napatGNK/Solar-MPPT-Boost-Charge-Controller/README.md

# Solar MPPT Boost Charge Controller

เครื่องควบคุมการชาร์จแบตเตอรี่จากแผงโซลาร์เซลล์แบบ MPPT ออกแบบและสร้างบนแผ่นปรุขนาด 9×15 ซม.

**ESP32 · Boost converter · P&O MPPT · แผง 20W → แบต SLA 12V 7Ah**

> **สถานะ:** บอร์ดประกอบเสร็จ ผ่านการตรวจไฟเลี้ยงและระบบสื่อสาร I2C แล้ว อยู่ระหว่างตรวจสอบสัญญาณขับเกต ยังไม่ผ่านการทดสอบชาร์จจริง — รายละเอียดอยู่ในหัวข้อ "บันทึกการแก้ปัญหา"

ผลงานของ นายณภัทร เครือสุวรรณ

หมายเหตุ

พัฒนาโดยใช้ AI ช่วยร่างโค้ดและตรวจทานแบบวงจรและช่วยแก้ใขในบางส่วนที่ผิดผลาด ส่วนการออกแบบ ประกอบ ทดสอบ และวัดผลทั้งหมด ผู้ทำ
ไฟล์ทั้งหมด ใช้ AI ช่วยทำในการทำให้ออกมาอ่านง่าย โดยมี data มาจากผู้ทำ
---

## สเปคระบบ

| หัวข้อ | ค่า |
|---|---|
| แผงโซลาร์ | 20W · Vmp ~12V · Imp 1.11A · Voc วัดจริง ~15V |
| แบตเตอรี่ | YACHU 6-FM-7 · SLA 12V 7Ah |
| โทโพโลยี | Non-synchronous boost converter |
| ความถี่สวิตช์ | 50 kHz · duty ที่จุดทำงาน ~0.17 |
| MOSFET | IRF3205 ฝั่งต่ำ ขับด้วยขา LO ของ IR2104 |
| ไดโอด | MBR20100CT (Schottky) |
| ตัวเหนี่ยวนำ | 100µH / 10A ทอรอยด์ |
| การวัด | INA219 ×2 (ฝั่งแผง 0x40 · ฝั่งแบต 0x41) |
| อัลกอริทึม | Perturb & Observe |
| แรงดันเป้าหมาย | absorb 14.20V · float 13.50V (คงที่) |

---

## ไฟล์ในรีโป

| ไฟล์ | คำอธิบาย |
|---|---|
| `solar_mppt_boost.ino` | เฟิร์มแวร์หลัก MPPT + ควบคุมแรงดันคงที่ |
| `solar_mppt_bench_test.ino` | สเก็ตช์ทดสอบ สั่ง duty ด้วยมือผ่าน Serial |
| `design.md` | เอกสารออกแบบ · ตารางขาต่อขา · การคำนวณกำลังสูญเสีย |
| `test_plan.md` | แผนทดสอบ 8 ขั้นและข้อกำหนดความปลอดภัย |
| `wiring_map.svg` | ผังต่อสาย |
| `bom.md` | รายการอุปกรณ์ทั้งหมด |
| `qrcode_รูปภาพและคลิปประกอบ.png` | รูปภาพและคลิปประกอบ |
---

## แนวคิดการออกแบบ

### 1. เปลี่ยนจาก buck เป็น boost หลังวัดแผงจริง

แบบเดิมออกแบบเป็น buck converter ตามป้ายสเปคที่ติดมากับแผง แต่ป้ายนั้นพิมพ์ **Voc 8.1V ซึ่งต่ำกว่า Vmp 12V** ที่พิมพ์อยู่บนป้ายเดียวกัน

Voc คือแรงดันขณะไม่มีโหลด จึงต้องสูงกว่า Vmp เสมอ ค่านี้เป็นไปไม่ได้ทางฟิสิกส์

วัดจริงด้วยมัลติมิเตอร์ได้ Voc ประมาณ 15V ขณะฟ้าครึ้ม สรุปว่าเป็นแผงแรงดันต่ำที่ Vmp อยู่ราว 12V ซึ่ง **ต่ำกว่าแรงดันชาร์จของ SLA ที่ต้องการ 14.4V** จึงต้องดันขึ้น ไม่ใช่ลดลง เปลี่ยนโทโพโลยีเป็น boost ทั้งหมด

บทเรียน: อย่าเชื่อป้ายสเปค วัดก่อนออกแบบ

### 2. คำนวณกำลังสูญเสียก่อนเลือกฮีตซิงก์

| จุด | กำลังที่เสีย |
|---|---|
| D1 สวิตชิ่ง | **0.42W** ← มากที่สุด |
| ชันต์ INA219 ทั้งสองตัว | 0.21W |
| Q1 สวิตชิ่ง | 0.14W |
| Q1 นำกระแส | 0.002W |

MOSFET กระแสต่ำและ Rds(on) เพียง 8mΩ จึงแทบไม่ร้อน ตัวที่ต้องระบายความร้อนคือไดโอด **ติดฮีตซิงก์ตัวเดียวที่ D1** ประหยัดทั้งพื้นที่บอร์ดและค่าอุปกรณ์

ตรวจเพิ่มเติม: ริปเปิลใน L1 = 0.40A p-p บนกระแสเฉลี่ย 1.11A อยู่ในโหมด CCM · กระแสพีค 1.3A จากพิกัด 10A · Vds สูงสุด ~15V จากพิกัด 55V

### 3. ยืนยันขาไดรเวอร์จากดาต้าชีตตัวจริง

IR2104 มีอินพุตเดียว (IN) และดาต้าชีต Infineon PD60046-P ระบุว่า **HO อยู่ในเฟสเดียวกับ IN** ซึ่งแปลว่า LO กลับเฟสกับ IN เสมอ

เนื่องจากวงจรนี้ใช้ MOSFET ฝั่งต่ำตัวเดียว ขับด้วยขา LO ค่าที่เขียนออก GPIO จึงต้องเป็น `1 − duty` ไม่ใช่ `duty` โดยตรง โค้ดรวมการกลับเฟสไว้ในฟังก์ชันเดียว (`setDutyQ1`) เพื่อไม่ให้เผลอเรียก `ledcWrite()` ตรง ๆ จากที่อื่น

การอ่านดาต้าชีตรอบนี้ยังพบว่าแบบร่างเดิมสลับขา 7 (HO) กับขา 8 (VB) ซึ่งจะเป็นการต่อเอาต์พุตเข้ากับไฟเลี้ยง — ไอซีพังทันทีที่จ่ายไฟ

### 4. วิธีตรวจสอบเฟสโดยไม่มีออสซิลโลสโคป

ไม่มีสโคป จึงออกแบบวิธีวัดจากหลักการที่ว่า **มัลติมิเตอร์ในโหมด DC อ่านค่าเฉลี่ยของสัญญาณพัลส์**

แรงดันเฉลี่ยที่ขาเกตจึงควรเท่ากับ `duty × Vin`

| สั่ง duty | เกตควรได้ | ถ้าได้แบบนี้คือเฟสกลับ |
|---|---|---|
| 0.10 | ~1.2V | ~10.8V |
| 0.20 | ~2.4V | ~9.6V |
| 0.30 | ~3.6V | ~8.4V |

วิธีนี้ยืนยันได้ทั้งค่า duty และเฟสของสัญญาณขับ ด้วยเครื่องมือราคาไม่กี่ร้อยบาท

### 5. ข้อจำกัดที่แก้ด้วยซอฟต์แวร์ไม่ได้

**Boost converter ตัดวงจรเองไม่ได้** เมื่อ MOSFET ปิดสนิท กระแสจากแผงยังไหลผ่าน L1 → D1 → แบตอยู่ดี ได้แรงดันราว Voc − 0.5V ≈ 15V ซึ่งสูงกว่าแรงดัน absorb

แปลว่าโค้ดป้องกันการชาร์จเกินได้เพียงบางส่วน ทางแก้ที่สมบูรณ์คือเพิ่มรีเลย์ตัดสาย **ฝั่งแผง** ควบคุมด้วย GPIO27 (เฟิร์มแวร์รองรับแล้วผ่าน `#define USE_RELAY`)

ต้องตัดฝั่งแผงไม่ใช่ฝั่งแบต เพราะการตัดโหลดขณะกำลังสวิตช์จะทำให้แรงดันเอาต์พุตพุ่ง

การระบุข้อจำกัดนี้ไว้ตรง ๆ พร้อมเสนอวิธีแก้ ถือว่าตรงไปตรงมากว่าการซ่อนไว้

---

## ความปลอดภัย

ระบบ 12–16V ไม่ทำให้ไฟดูด แต่มีอันตรายจริงสามอย่างที่ต้องออกแบบรับมือ

**แบต SLA ลัดวงจร** — แบต 12V 7Ah จ่ายกระแสตอนลัดวงจรได้เกิน 150A สายไฟไหม้ในไม่กี่วินาที จึงเพิ่ม **ฟิวส์ 3A (F2) อนุกรมในสายบวกของแบต** ติดขั้วแบตที่สุด

แบบร่างเดิมมีฟิวส์เฉพาะฝั่งแผง ซึ่งจริง ๆ อันตรายน้อยกว่าเพราะแผงจำกัดกระแสตัวเองที่ 1.22A อยู่แล้ว ฝั่งแบตต่างหากที่จ่ายกระแสได้ไม่จำกัด

**Boost ที่ไม่มีโหลด** — แรงดันเอาต์พุตจะไต่ขึ้นจนพังตัวเอง เพราะพลังงานที่อัดเข้า Cout ทุกรอบไม่มีที่ระบาย ทุกการทดสอบที่มีการสวิตช์จึงต้องมีโหลดจำลอง (หลอด 12V 5W) ต่ออยู่เสมอ

**ระบบตัดอัตโนมัติในเฟิร์มแวร์** — Vout > 17V · Iin > 1.8A · Vin < 8V · เปิดค้างเกิน 10 นาที

---

## แผนทดสอบ 8 ขั้น

```
T1  ตรวจลัดวงจร        ไม่จ่ายไฟ
T2  ไฟเลี้ยง           จ่ายไฟ ยังไม่เสียบ IC
T3  ระบบดิจิทัล        เสียบ IC ยังไม่สวิตช์
T4  ตรวจเฟสไดรเวอร์    มีโหลดจำลอง  ← สำคัญที่สุด
T5  ยืนยันการ boost    มีโหลดจำลอง
T6  ต่อแบต             ต้องมี F2 ก่อน
T7  เฟิร์มแวร์จริง      เฝ้า 30 นาที
T8  เปลี่ยนเป็นแผงจริง
```

หลักการคือ **ทุกขั้นต้องพิสูจน์ตัวเองก่อนที่จะเพิ่มตัวแปรถัดไป** ไม่เสียบไอซีจนกว่าไฟเลี้ยงจะยืนยันแล้วว่าถูกต้อง ไม่ต่อแบตจนกว่าจะรู้ว่าวงจร boost ทำงานจริง

---

## บันทึกการแก้ปัญหา

### OLED เสียจากการต่อกลับขั้ว

ต่อ VCC กับ GND สลับกัน โมดูลร้อนและหายไปจากบัส I2C ถาวร

แก้ที่ซอฟต์แวร์ด้วยการให้เฟิร์มแวร์ตรวจหาจอตอนบูตครั้งเดียว ถ้าไม่พบก็ข้ามการแสดงผลทั้งหมดแล้วรันต่อได้ปกติ เดิมโค้ดยังส่งข้อมูลราว 1KB ไปหาจอที่ไม่มีอยู่ทุก 500ms ซึ่งกินเวลาบัสและเสี่ยงทำให้ระบบค้าง

### เสียไอซีไดรเวอร์(ina 219 สองตัวจากขาที่งอ)

ขา DIP-8 ที่ออกจากโรงงานบานออกกว้างกว่ารูซ็อกเก็ต ถ้าไม่บีบให้ตรงก่อน ขาจะพับเข้าใต้ตัวไอซีแทนที่จะลงรู แล้วไปแตะขาข้างเคียง

ตัวแรกขา 8 (VB) พับไปแตะขา 7 (HO) = เอาไฟเลี้ยงชนเอาต์พุต วัดได้ว่าไฟเลี้ยงตกจาก 12V เหลือ 8.5V คำนวณย้อนได้กระแสรั่ว 350mA ซึ่งมากกว่ากระแสสปกติของไอซีถึง 300 เท่า

วิธีที่ถูกคือวางตัวไอซีตะแคงบนโต๊ะเรียบ กดขาทั้งแถวให้ขนานกันก่อน แล้ววางลงซ็อกเก็ตโดยยังไม่กด ตรวจว่าปลายขาทั้ง 8 เข้ารูครบ จึงค่อยกดลงตรง ๆ และรูยังมีความแน่นต้องใช้ไขควงเล็กเสียบเบาให้ช่องเปิดออก

### ไล่หาสาเหตุผิดทางเพราะวัดผิดตำแหน่งขา

อาการ: สั่ง duty แล้ววัดแรงดันที่ MOSFET ได้ 0V ทำให้สรุปว่าไดรเวอร์ไม่ทำงาน

ไล่ตรวจไปหลายชั่วโมง — วัดความต่อเนื่องของสายทุกเส้น ตรวจว่าตัวต้านทานพูลดาวน์ค่าถูกต้อง (9.98kΩ) ยืนยันว่าไม่มีจุดลัดวงจร เปลี่ยนไอซีตัวใหม่ ผลเหมือนเดิมทุกครั้ง

สาเหตุจริงคือ **วัดที่ขา Source ซึ่งต่อกราวด์อยู่แล้ว จึงได้ 0V เสมอไม่ว่าวงจรจะทำงานหรือไม่** ขา Gate ที่ควรวัดอยู่คนละตำแหน่ง

บทเรียนที่ได้จริง: ก่อนสรุปว่าอุปกรณ์เสีย ต้องยืนยันก่อนว่ากำลังวัดถูกจุด ค่าที่วัดจากตำแหน่งผิดไม่ใช่แค่ไม่มีประโยชน์ แต่นำไปสู่วิธ๊แก้ปัญหาที่ผิดผลาด เวลาทำงานต้องมีสติแม้มีเวลามากดดันไม่งั้นจะทำให้แย่กว่าเดิม

วิธียืนยันขา TO-220 ที่เชื่อถือได้: แผ่นโลหะด้านหลัง (tab) เชื่อมกับขา Drain เป็นชิ้นเดียวกันทางกายภาพเสมอ วัดความต่อเนื่องจาก tab ไปหาแต่ละขา ขาที่ร้องคือ Drain ใช้อ้างอิงหาขาที่เหลือได้โดยไม่ต้องเดาจากทิศทางที่เสียบ

### สเก็ตช์ทดสอบที่ปล่อยขาอินพุตลอย

เขียนสเก็ตช์สั้น ๆ เพื่อทดสอบขา shutdown โดยตั้ง `pinMode` เฉพาะขานั้น ไม่ได้แตะขา PWM เลย

ขา IN ของ IR2104 ไม่มีตัวต้านทานดึงภายใน พอปลายทางลอยจึงรับสัญญาณรบกวนแล้วสวิตช์แบบสุ่ม เกิดเสียงหวีดจากตัวเหนี่ยวนำและหลอดโหลดสว่างวูบวาบ

บทเรียน: สเก็ตช์ทดสอบต้องกำหนดสถานะของ**ทุกขา**ที่ต่อกับวงจรกำลัง ไม่ใช่เฉพาะขาที่กำลังสนใจ ขาที่ปล่อยลอยไว้คือขาที่ควบคุมไม่ได้

### สายหลวมสร้างแรงดันเกินพิกัด

ช่วงแรกใช้คลิปปากจระเข้คีบสายไฟบนบอร์ดแทนการขันเข้าเทอร์มินอลบล็อก วัดแรงดันเอาต์พุตได้ 0V สลับกับ 18V เป็นช่วง ๆ ทั้งที่อะแดปเตอร์จ่ายเพียง 12V ทำให้ ina 219 เสีย 1 ตัว

สาเหตุคือหน้าสัมผัสหลุด ๆ ติด ๆ ตัดกระแสในตัวเหนี่ยวนำกะทันหัน เกิดแรงดันเหนี่ยวนำย้อนกลับ ซึ่ง 18V เกินพิกัดของอุปกรณ์ 3.3V ที่ต่ออยู่บนบัสเดียวกัน

---

## สิ่งที่เหลือ

- [ ] ยืนยันสัญญาณขับเกตและเฟส (ขั้น T4)
- [ ] ทดสอบ boost ด้วยโหลดจำลอง (ขั้น T5)
- [ ] ทดสอบชาร์จแบตจริงและเก็บ log เป็น CSV
- [ ] พล็อตกราฟ P-V เพื่อยืนยันว่า MPPT หาจุดสูงสุดได้จริง
- [ ] ติดรีเลย์ตัดสายแผงเพื่อป้องกันการชาร์จเกินอย่างสมบูรณ์
- [ ] เปลี่ยนจอ OLED ตัวใหม่

---

## เครื่องมือที่ใช้

มัลติมิเตอร์แบบปรับย่านเอง · หัวแร้ง · อะแดปเตอร์ 12V/2A แทนแผงตอนทดสอบบนโต๊ะ

ไม่มีออสซิลโลสโคปและไม่มีแหล่งจ่ายไฟปรับค่าได้ ข้อจำกัดนี้เป็นที่มาของวิธีวัดเฟสด้วยค่าเฉลี่ยในหัวข้อที่ 4

---

## หมายเหตุ

พัฒนาโดยใช้ AI ช่วยร่างโค้ดและตรวจทานแบบวงจร ส่วนการออกแบบ ประกอบ ทดสอบ และวัดผลทั้งหมด ผมทำเอง
