napatGNK/Solar-MPPT-Boost-Charge-Controller/bom.md

# รายการอุปกรณ์

## วงจรกำลัง

| อุปกรณ์ | สเปค | จำนวน | หมายเหตุ |
|---|---|---|---|
| MOSFET | IRF3205 (55V / 110A / 8mΩ) | 1 | ฝั่งต่ำ ไม่ต้องใช้ฮีตซิงก์ |
| ไดโอด | MBR20100CT Schottky (100V / 20A) | 1 | ตัวเดียวที่ต้องมีฮีตซิงก์ |
| ตัวเหนี่ยวนำ | 100µH / 10A ทอรอยด์ | 1 | |
| Cin | 470µF / 25V อิเล็กโทรไลต์ | 1 | |
| Cout | 1000µF / 25V อิเล็กโทรไลต์ | 1 | |
| C บายพาส | 0.1µF เซรามิก | 4 | ไฟเลี้ยง · VB-VS · NODE CIN · NODE OUT |
| ฮีตซิงก์ | TO-220 | 1 | ให้ D1 |
| แผ่นฉนวนไมก้า + บูช | ชุด TO-220 | 1 | tab ของ D1 คือ NODE OUT |

## ไดรเวอร์เกต

| อุปกรณ์ | สเปค | จำนวน | หมายเหตุ |
|---|---|---|---|
| Gate driver | IR2104 DIP-8 | 1 | ใช้เฉพาะฝั่ง LO |
| ซ็อกเก็ต | DIP-8 | 1 | ถอดเปลี่ยนได้ ไม่บัดกรีไอซีตรง |
| R gate | 10Ω 1/4W | 1 | ขา 5 → Gate |
| R pull-down | 10kΩ 1/4W | 2 | Gate→GND และ SD→GND |
| R ไฟเลี้ยง | 10Ω 1/4W | 1 | NODE IN → ขา 1 |
| C ไฟเลี้ยง | 10µF / 25V | 1 | คร่อมขา 1 ลง GND |

## ควบคุมและวัดผล

| อุปกรณ์ | สเปค | จำนวน | หมายเหตุ |
|---|---|---|---|
| ไมโครคอนโทรลเลอร์ | ESP32 DevKit 30 ขา | 1 | ชิป USB-UART CP2102 |
| บอร์ดขยาย | ESP32 30P expansion board | 1 | แถว S / V / G ต่อขา |
| เซนเซอร์กระแส | INA219 | 2 | 0x40 ฝั่งแผง · 0x41 ฝั่งแบต (จั๊ม A0) |
| เรกูเลเตอร์ | MP1584EN | 1 | รุ่นเอาต์พุตคงที่ วัดได้ ~5.22V |
| จั๊มเปอร์เลือกแหล่งจ่าย | 2 ขา | 1 | กัน USB ชนกับ 5V ภายนอก |
| จอแสดงผล | OLED SSD1306 128×64 (0x3C) | 1 | เสียจากต่อกลับขั้ว รอเปลี่ยน |

## โครงสร้างและการเชื่อมต่อ

| อุปกรณ์ | สเปค | จำนวน |
|---|---|---|
| แผ่นปรุ | 9 × 15 ซม. | 1 |
| เทอร์มินอลบล็อก | 2 ขา (TB1 แผง · TB2 แบต) | 2 |
| ฐานฟิวส์ + ฟิวส์ | 2A ฝั่งแผง (F1) | 1 |
| ฟิวส์กระบอกมีสาย | 3A ฝั่งแบต (F2) | 1 |
| สายไฟบนบอร์ด | ทองแดง 0.6mm | — |
| สายไฟกำลัง | 22 AWG | — |

## แหล่งพลังงานและโหลด

| อุปกรณ์ | สเปค | หมายเหตุ |
|---|---|---|
| แผงโซลาร์ | 20W · Vmp ~12V · Imp 1.11A | ป้ายพิมพ์ Voc ผิด วัดจริงได้ ~15V |
| แบตเตอรี่ | YACHU 6-FM-7 · SLA 12V 7Ah | ขั้ว F2 faston · cyclic 14.5–14.9V |
| อะแดปเตอร์ | 12V / 2A center-positive | ใช้แทนแผงตอนทดสอบบนโต๊ะ |

## อุปกรณ์สำหรับการทดสอบ

| อุปกรณ์ | สเปค | ใช้ทำอะไร |
|---|---|---|
| มัลติมิเตอร์ | ZENTOR ZT34000 ปรับย่านเอง | วัดทุกอย่าง รวมถึงวัดเฟสด้วยค่าเฉลี่ย |
| โหลดจำลอง | หลอด 12V 5W หรือ R 33Ω 10W | บังคับต้องมีทุกครั้งที่สวิตช์ |
| ตัวต้านทานคายประจุ | 100Ω | คร่อม Cout หลังตัดไฟ |
| คลิปปากจระเข้ | — | ปลดสายแบตได้ใน 1 วินาที |
| แว่นตานิรภัย | — | บังคับ |
| กระดาษลัง | — | คลุมแผงตอนต่อสาย |

## ที่ตัดออกจากแบบร่างเดิม

| อุปกรณ์ | เหตุผล |
|---|---|
| เรกูเลเตอร์ 7812 | IR2104 รับไฟเลี้ยงได้ถึง 20V จ่ายจาก NODE IN ผ่าน R 10Ω ได้เลย |
| Cboot 1µF + ไดโอด bootstrap | ใช้เฉพาะฝั่ง LO จึงไม่ต้องมีวงจร bootstrap |
| ฮีตซิงก์ตัวที่ 2 | คำนวณแล้ว Q1 สูญเสียเพียง 0.14W |
| DS18B20 | ตัดออกเพื่อลดความซับซ้อน ใช้แรงดันเป้าหมายคงที่แทน |

## ยังไม่ได้ติดตั้ง

| อุปกรณ์ | ใช้ทำอะไร |
|---|---|
| รีเลย์ 5V | ตัดสายแผงเมื่อแบตเต็ม แก้ข้อจำกัดที่ boost ตัดวงจรเองไม่ได้ |
