napatGNK/Solar-MPPT-Boost-Charge-Controller/test_plan.md

# แผนทดสอบและความปลอดภัย — Rev.3.3

แก้จาก Rev.3.2: ตัด DS18B20 ออกทั้งหมด · เพิ่มตารางขา ESP32 · เพิ่มกฎเช็คอุณหภูมิแบตด้วยมือ

---

# ส่วนที่ 1 — ความปลอดภัยส่วนบุคคล

## อันตรายที่แท้จริง ไม่ใช่ไฟดูด

ระบบ 12–16V ไม่ทำให้ไฟดูด แต่มีอันตรายจริง 3 อย่าง

**1. แบต SLA ลัดวงจร**
แบต 12V 7Ah จ่ายกระแสตอนลัดวงจรได้เกิน 150A สายไฟจะร้อนแดงและไหม้ในไม่กี่วินาที แหวนหรือประแจที่พาดขั้วจะร้อนจนลวกมือทันทีและถอดออกไม่ทัน

**2. ตัวเก็บประจุระเบิด**
ต่อกลับขั้วหรือจ่ายเกินพิกัด อิเล็กโทรไลต์จะระเบิดพ่นของเหลวและเศษฟอยล์ออกมา ตรงระดับสายตาพอดี

**3. แผงมีไฟตลอดเวลาที่มีแสง**
ไม่มีสวิตช์ปิด ตราบใดที่มีแสงตกกระทบ ขั้วแผงมีไฟเสมอ

## กฎที่ต้องทำทุกครั้ง

- **ใส่แว่นตานิรภัย** ตอนจ่ายไฟครั้งแรกของทุกด่าน และตอนบัดกรี
- **ถอดแหวน นาฬิกา สร้อยข้อมือ** ก่อนจับแบต
- **คลุมแผงด้วยกระดาษลัง** ทุกครั้งที่ต่อสายฝั่งแผง อย่าอาศัยว่าเมฆบัง
- **ทดสอบบนพื้นผิวไม่ติดไฟ** กระเบื้องหรือไม้อัด ห้ามบนผ้าหรือกระดาษ
- **ปลายสายแบตใช้คลิปปากจระเข้** ปลดได้ในหนึ่งวินาที ไม่ใช่ขันน็อตแน่น

## ⚠️ F2 — ฟิวส์ฝั่งแบต

ฟิวส์ **3A** อนุกรมในสายบวกของแบต ระหว่างขั้วแบตกับ TB2 ใช้กระบอกฟิวส์แบบมีสายในตัว ให้อยู่ติดขั้วแบตที่สุด

F1 ที่ออกแบบไว้อยู่ฝั่งแผงซึ่งอันตรายน้อย เพราะแผงจำกัดกระแสตัวเองที่ 1.22A อยู่แล้ว ฝั่งแบตต่างหากที่อันตราย

**ห้ามต่อแบตโดยไม่มี F2**

## ตัวเก็บประจุยังมีไฟหลังปิดเครื่อง

Cout ที่ 14V เก็บพลังงานราว 0.1 จูล ไม่พอทำอันตรายคน แต่พอทำให้เกิดประกายและช็อตอุปกรณ์

หลังปิดไฟทุกครั้ง เอาตัวต้านทาน 100Ω คร่อม Cout สัก 5 วินาที แล้ววัดยืนยันว่าต่ำกว่า 1V

## ⚠️ ไม่มีเซนเซอร์อุณหภูมิแล้ว — ต้องเช็คด้วยมือแทน

ตัด DS18B20 ออกจากระบบแล้ว เฟิร์มแวร์จึงชดเชยแรงดันตามอุณหภูมิไม่ได้ ตั้งค่าไว้คงที่ที่ **absorb 14.20V · float 13.50V** (ลดจากค่ามาตรฐาน 25°C มาแล้วเผื่ออุณหภูมิห้องบ้านเรา ~33°C)

**กฎที่มาแทนเซนเซอร์**

- ระหว่างชาร์จ ให้แตะตัวแบตเช็คทุก 15–20 นาที
- ตัวแบตควรอุ่นนิดเดียว ถ้าร้อนจนแตะค้างไม่ได้ = **หยุดชาร์จทันที**
- ถ้าทดสอบในห้องแอร์ต่ำกว่า 25°C ค่อยปรับ `V_ABSORB` ขึ้นเป็น 14.40 ได้
- เขียนข้อจำกัดนี้ลงรายงานด้วย เป็นจุดที่อาจารย์ถามแน่

---

# ส่วนที่ 2 — ของที่ต้องมีก่อนทดสอบ

- แว่นตานิรภัย — บังคับ
- ฟิวส์ 3A + กระบอกฟิวส์แบบมีสาย — บังคับ
- **หลอด 12V 5W** หรือตัวต้านทาน 33Ω 10W — บังคับ
- อะแดปเตอร์ 12V
- ตัวต้านทาน 100Ω สำหรับคายประจุ
- คลิปปากจระเข้
- กระดาษลังคลุมแผง

## ทำไมต้องมีโหลดจำลอง

Boost ที่ทำงานอยู่แต่ไม่มีโหลด แรงดันเอาต์พุตจะไต่ขึ้นเรื่อย ๆ จนพังตัวเอง เพราะพลังงานที่อัดเข้า Cout ทุกรอบไม่มีที่ระบาย

**ห้ามสั่งให้วงจรสวิตช์โดยไม่มีอะไรต่อที่เอาต์พุตเด็ดขาด** ไม่ว่า duty จะต่ำแค่ไหน

---

# ส่วนที่ 3 — ขา ESP32 และของที่ต้องลงใน Arduino IDE

## ขาบนบอร์ด

ตัวอักษร **D** ที่พิมพ์บนบอร์ด ESP32 DevKit เป็นแค่คำนำหน้า เลขหลัง D คือเลข GPIO ตรง ๆ ไม่ต้องแปลงค่า

| พิมพ์บนบอร์ด | ในโค้ด | ต่อไปที่ |
|---|---|---|
| D25 | 25 | IR2104 ขา 2 (IN) — PWM |
| D26 | 26 | IR2104 ขา 3 (SD) |
| D21 | 21 | SDA |
| D22 | 22 | SCL |
| D27 | 27 | รีเลย์ (ยังไม่ติด) |

D4 ที่เคยใช้กับ DS18B20 **ว่างแล้ว ไม่ต้องต่ออะไร**

> ที่ D2 = GPIO4 คือบอร์ด **ESP8266** NodeMCU คนละตระกูลกัน ถ้าบอร์ดมีขา D32 D33 D34 D35 หรือ VP VN แปลว่าเป็น ESP32 แน่นอน

## Arduino IDE

**Board Manager** → ค้น `esp32` ลงของ Espressif Systems → เลือกบอร์ด "ESP32 Dev Module"

**Library Manager** → ลง 3 ตัว
- Adafruit INA219
- Adafruit SSD1306 (จะลาก Adafruit GFX + BusIO มาเอง กด Install All)
- ~~OneWire · DallasTemperature~~ ไม่ต้องแล้ว

โค้ดทั้งสองไฟล์รองรับ ESP32 core ทั้ง 2.x และ 3.x ในตัว ไม่ต้องเลือกเวอร์ชัน

---

# ด่าน T1 — ตรวจการลัดวงจร

ไม่จ่ายไฟเลย ใช้มิเตอร์โหมดเสียง

**ต้องไม่ร้อง**
- NODE IN ↔ GND-P
- NODE CIN ↔ GND-P
- NODE SW ↔ GND-P
- NODE OUT ↔ GND-P
- NODE IN ↔ NODE CIN (มีชันต์คั่น)
- NODE SW ↔ NODE OUT
- socket ขา 5 ↔ GND
- **socket ขา 7 ↔ ทุกจุดในบอร์ด**

**ต้องร้อง**
- NODE CIN ↔ NODE SW (L1 เป็นลวด)
- GND-P ↔ GND-S (เชื่อมจุดเดียว)
- socket ขา 8 ↔ socket ขา 1
- socket ขา 4 ↔ GND
- socket ขา 6 ↔ GND

ข้อไหนไม่ตรง หยุด แก้ก่อน

---

# ด่าน T2 — ไฟเลี้ยง

**ยังไม่เสียบ IC · ยังไม่เสียบ ESP32 · ยังไม่ต่อแบต · ใส่ F1 แล้ว**

1. วัดขั้วอะแดปเตอร์ก่อน ย่าน 20V DC ต้องเห็นเลขบวก
2. ต่ออะแดปเตอร์เข้า TB1
3. วัดตามนี้

**MP1584 OUT+ ↔ GND**
ปรับสกรูจนได้ **5.00V** เกิน 5.5V คือ ESP32 พังทันทีเมื่อเสียบ

**socket ขา 1 ↔ GND**
ต้องได้ 11.8–12.0V ถ้าต่ำกว่า 10V เช็ค R 10Ω

**NODE OUT ↔ GND**
ประมาณ 11.4V — ไหลผ่าน L1 กับ D1 มาเอง เป็นเรื่องปกติ

**แตะเช็คทุกตัว** ต้องไม่มีตัวไหนอุ่น ถ้าอุ่นแปลว่ามีที่ผิด ตัดไฟทันที

4. ปิดไฟ คายประจุ Cout แล้วเสียบ IR2104 และ ESP32

---

# ด่าน T3 — ระบบดิจิทัล

อัปโหลด `solar_mppt_bench_test_rev32.ino` ซึ่งเริ่มด้วย SD ปิดและ duty ศูนย์

**ต้องได้**
- I2C scan เจอ 0x40, 0x41, 0x3C ครบ
- Serial อ่าน Vin ได้ราว 12V
- OLED ติดและแสดงตัวเลข
- socket ขา 3 ↔ GND ได้ 0V (SD ยังปิด)

---

# ด่าน T4 — ตรวจเฟสไดรเวอร์

**ด่านสำคัญที่สุดของทั้งโปรเจค** ถ้าเฟสกลับผิด Q1 จะเปิดค้างเกือบตลอดเวลา

## ก่อนเริ่ม
- ต่อโหลดจำลองที่ TB2 (หลอด 12V 5W หรือ 33Ω 10W)
- **ยังไม่ต่อแบต**
- ใส่แว่นตา
- นิ้ววางบนปลั๊กอะแดปเตอร์ พร้อมกระชากออก

## วิธีทำ

พิมพ์ใน Serial Monitor
```
e
d 0.10
```

สเก็ตช์จะบอกเองว่าควรวัดได้เท่าไหร่ (พิมพ์ `g` ซ้ำได้ตลอด)

**วัดแรงดันเฉลี่ยที่ขา Gate ของ Q1 เทียบ GND** ย่าน 20V DC

มิเตอร์อ่านค่าเฉลี่ยของพัลส์ ดังนั้นค่าที่ได้ควรเท่ากับ duty × 12V

| สั่ง duty | Gate ควรได้ | ถ้าได้แบบนี้คือผิด |
|---|---|---|
| 0.10 | ~1.2V | ~10.8V |
| 0.20 | ~2.4V | ~9.6V |
| 0.30 | ~3.6V | ~8.4V |

**ถ้าเฟสกลับผิด พิมพ์ `s` หยุดทันที อย่าปล่อยเกิน 2-3 วินาที แล้วบอกผม**

วิธีนี้ใช้แทนออสซิลโลสโคปได้ในระดับที่ยืนยันเฟสและ duty ได้แม่นพอ

---

# ด่าน T5 — ยืนยันการ boost

ยังต่อโหลดจำลองอยู่ ไล่ duty ขึ้นทีละขั้น หยุดที่ 0.25

| duty | Vin | Vout | อัตราส่วน |
|---|---|---|---|
| 0 | 12.0 | ~11.4 | ผ่านไดโอด |
| 0.10 | ~11.9 | ~12.6 | 1.06 |
| 0.15 | ~11.8 | ~13.3 | 1.13 |
| 0.20 | ~11.7 | ~14.0 | 1.20 |
| 0.25 | ~11.6 | ~14.7 | 1.27 |

ค่าจริงต่ำกว่าสูตรอุดมคติราว 5-10% ถือว่าปกติ
**หลอดควรค่อย ๆ สว่างขึ้นตาม duty**

## เกณฑ์หยุดทันที

- **Vout เกิน 17V** — สเก็ตช์ตัดให้เอง ถ้าไม่ตัดให้กระชากปลั๊ก
- **ได้กลิ่นไหม้** — กระชากปลั๊ก อย่าเสียเวลาพิมพ์
- **ตัวใดร้อนจนแตะไม่ได้** — ตัดไฟ หาสาเหตุ
- **เสียงหวีดดังผิดปกติจาก L1** — ลด duty เสียงเบา ๆ ปกติ
- **ESP32 รีเซ็ตเองตอนเพิ่ม duty** — ปัญหากราวด์ ตัดไฟตรวจราง

เกณฑ์อุณหภูมิ: แตะค้างนิ้วได้ 5 วินาที = ปกติ · ต้องรีบดึงมือ = มีปัญหา

รันค้างที่ duty 0.20 นาน 5 นาที แล้วแตะเช็คทุกตัว ถ้าไม่มีใครร้อนผิดปกติ ถือว่าผ่าน

---

# ด่าน T6 — ต่อแบต

**ลำดับนี้ห้ามสลับ**

1. พิมพ์ `s` หยุดสวิตช์
2. ถอดอะแดปเตอร์
3. คายประจุ Cout ด้วย 100Ω
4. ถอดโหลดจำลอง
5. **ต่อ F2 เข้ากับสายบวกของแบตก่อน**
6. วัดแรงดันแบต ควรได้ 12.0–12.9V
   - ต่ำกว่า 11.5V = คายลึกเกินไป อย่าเพิ่งใช้
   - ตัวแบตบวมหรือรั่ว = **ห้ามใช้เด็ดขาด**
   - **แตะตัวแบตด้วย ต้องเย็นหรืออุ่นนิดเดียว**
7. ต่อแบตเข้า TB2 ดูขั้วให้ตรง จะมีประกายเล็กน้อยตอนแรกเพราะ Cout ชาร์จ เป็นปกติ
8. ต่ออะแดปเตอร์กลับเข้า TB1
9. อ่านค่าก่อน ยังไม่เปิดไดรเวอร์ — Vbat ที่สเก็ตช์อ่านได้ควรตรงกับมิเตอร์ ±0.2V
10. `e` แล้ว `d 0.10` ค่อย ๆ ไล่ขึ้น ดูว่ากระแสชาร์จเพิ่มตาม

---

# ด่าน T7 — เฟิร์มแวร์จริง

อัปโหลด `solar_mppt_boost_rev32.ino`

**นั่งเฝ้าตลอดรอบแรก อย่างน้อย 30 นาที**

- ตอนบูตต้องขึ้นบรรทัดบอกเป้าหมาย absorb 14.20V · float 13.50V
- โหมดควรขึ้น MPPT และ duty ขยับขึ้นลงเล็กน้อยรอบค่าหนึ่ง
- duty แกว่ง ±1-2% = ปกติของ P&O
- **duty ชนเพดาน 40% ค้าง = ผิดปกติ** หาจุด MPP ไม่เจอ
- Vbat ค่อย ๆ ไต่ขึ้น ต้องไม่เกิน 14.2V ค้างนาน
- D1 อุ่นได้ แต่ต้องแตะค้างได้
- **แตะตัวแบตทุก 15–20 นาที** ร้อนเมื่อไหร่หยุดทันที

---

# ด่าน T8 — เปลี่ยนเป็นแผงจริง

1. หยุดวงจร ถอดอะแดปเตอร์
2. **คลุมแผงด้วยกระดาษลัง** แล้วค่อยต่อสายเข้า TB1 โดยวัดขั้วก่อน
3. เปิดเครื่อง แล้วค่อย ๆ เปิดกระดาษออก
4. ดูว่า Ipv เพิ่มตามแสง และ MPPT ไล่ตาม

---

# กฎการใช้งานหลังทดสอบเสร็จ

Boost ตัดวงจรเองไม่ได้ ต่อให้โค้ดสั่งปิด Q1 กระแสยังไหลผ่าน L1 → D1 → แบตอยู่ดี ได้ราว 15V ซึ่งสูงกว่า absorb

**โค้ดป้องกันการชาร์จเกินได้แค่บางส่วน ไม่ใช่ทั้งหมด**

- **ห้ามปล่อยชาร์จทิ้งไว้ข้ามคืนหรือตอนไม่มีคนอยู่** จนกว่าจะติดรีเลย์
- ทุกครั้งที่เลิกใช้ ถอดสายแผงออกจาก TB1
- ตรวจแรงดันแบตก่อนใช้ทุกครั้ง ถ้าเกิน 14.5V ตอนไม่ได้ชาร์จ แปลว่าเคยโดนชาร์จเกิน
- ชาร์จในที่อากาศถ่ายเท

ติดรีเลย์ตัดสายแผงที่ GPIO27 และเปิด `#define USE_RELAY` แล้วค่อยปล่อยทำงานเองได้

---

# ตารางแก้ปัญหา

**สั่ง duty แล้ว Gate ไม่มีแรงดันเลย**
→ SD ยังไม่ถูกดึงขึ้น · วัด socket ขา 3 ต้องได้ 3.3V ตอนสั่ง `e`

**Gate มีแรงดันแต่ Vout ไม่ขึ้น**
→ Q1 ขาสลับ หรือ D1 กลับด้าน · วัดโหมดไดโอดที่ D1 อีกครั้ง

**แรงดันเฉลี่ยที่ Gate สูงผิด (10V กว่า)**
→ เฟสกลับผิด · หยุดทันที แจ้งผม

**Vout ขึ้นเกินที่คำนวณมาก**
→ ไม่มีโหลด · ต่อโหลดจำลอง

**Q1 ร้อนเร็ว**
→ ไฟเลี้ยงต่ำกว่า 10V เกตเปิดไม่สุด · วัด socket ขา 1

**D1 ร้อนมาก**
→ อุ่นเป็นปกติ ถ้าร้อนจัดให้เช็คว่า duty สูงผิดปกติไหม · ดู log

**INA219 อ่านกระแสกระโดด**
→ สาย I2C เดินชิดสายกำลัง · ย้ายไปคอลัมน์ 6-8 ทางซ้าย

**ESP32 รีเซ็ตตอน duty สูง**
→ กราวด์สองรางปนกันหลายจุด · เช็คว่าเชื่อมที่คอลัมน์ 3 จุดเดียวจริง

**I2C ไม่เจอ 0x41**
→ ลืมจั๊ม A0 · ต้องถอดโมดูลออกมาจั๊ม

**คอมไพล์ไม่ผ่าน ฟ้อง OneWire หรือ DallasTemperature**
→ ยังใช้ไฟล์เก่า Rev.3.1 อยู่ · ใช้ rev32 แทน

**อัปโหลดโค้ดไม่ผ่าน**
→ ยังจ่ายไฟเข้า TB1 อยู่ · ถอดไฟก่อนเสียบ USB

---

# สรุปลำดับด่าน

```
T1  ตรวจลัดวงจร        ไม่จ่ายไฟ
T2  ไฟเลี้ยง           จ่ายไฟ ยังไม่เสียบ IC
T3  ระบบดิจิทัล        เสียบ IC ยังไม่สวิตช์
T4  ตรวจเฟสไดรเวอร์    มีโหลดจำลอง  ← สำคัญที่สุด
T5  ยืนยันการ boost    มีโหลดจำลอง
T6  ต่อแบต             ต้องมี F2 ก่อน
T7  เฟิร์มแวร์จริง      เฝ้า 30 นาที
T8  เปลี่ยนเป็นแผงจริง
```

**ห้ามข้ามด่าน ห้ามสลับลำดับ ด่านไหนไม่ผ่านให้หยุดถามก่อน**
